TahaGemici/archozu/DTR/DTR.docx

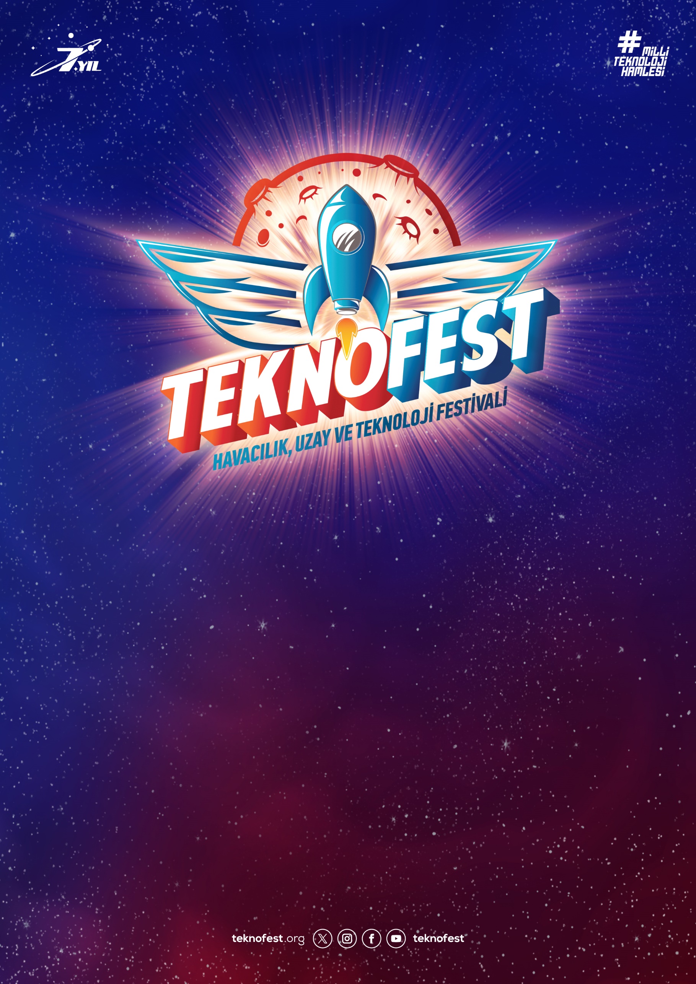
[picture p1: figure]

ÇİP TASARIM YARIŞMASI

2024

MİKRODENETLEYİCİ TASARIM KATEGORİSİ

DETAY TASARIM RAPORU

ArchOzU

……………………………….

2007098

………………………………

# 1. SİSTEM TANIMI VE TEMEL TASARIM ÖZETİ

Bu proje, OpenHW tarafından geliştirilen 4 aşamalı CV32E40P RISCV çekirdeğine çeşitli çevre birimlerini ekleyerek mikrokontrolcü yapmayı hedeflemektedir. Bu çevre birimleri şu şekildedir:

| RTL Tasarımı | UVM/Simülasyon Testi | İmplementasyon Testi
UART | ✓ | ✓ | 🛠
I2C Master | ✓ | ✓ | 🛠
QSPI Master | ✓ | ✓ | 🛠
Timer | ✓ | ✓ | ✓
GPIO | ✓ | ✓ | ✓
JTAG | ❌ | ❌ | ❌
USB | 🛠 | ❌ | ❌

Tablo 1: Çevre birimlerinin tamamlanma oranı

Yeşil renk tamamlandığını, sarı renk devam ettiğini ve kırmızı renk başlanmadığını göstermektedir.

Bu çevre birimlerinin çekirdek ile bağlantısının kurulabilmesi için bus ve çevre birimi belleği modülleri kullanılmıştır. USB ve JTAG, DTR sonrasına bırakılmıştır. Sistemin şu anki halinin fiziksel tasarımı tamamlanmıştır.

# 2. PROJE DETAY TASARIMI

## 2.1. Sistem Mimarisi

Projenin tamamlanan kısmının blok şeması aşağıdaki şekildedir:

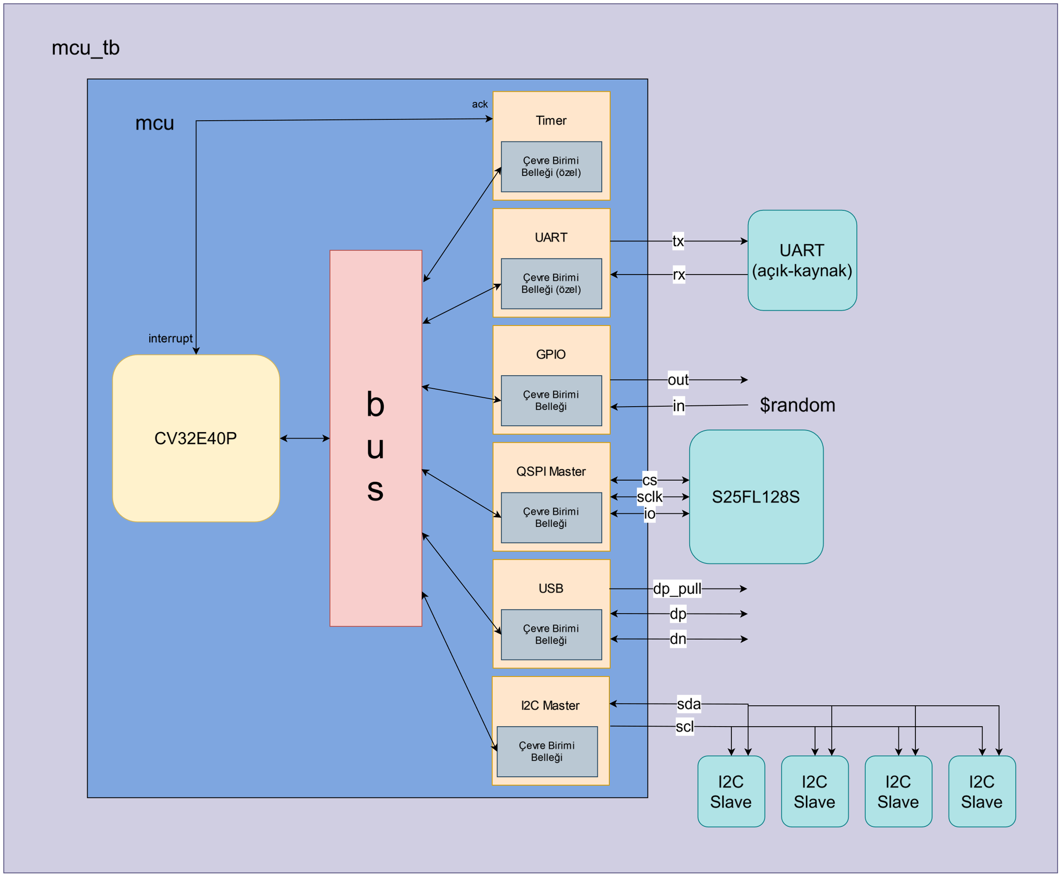
[picture p2: figure]

Şekil 1: Sistemin blok şeması

CV32E40P: Sistemin RISCV çekirdeği buradadır. Tüm işlemler burada yapılır.

Bus: Çevre birimleri ile çekirdek arasında aracılık yapar. Çekirdeğin tüm çevre birimlerine önceliği vardır yani tüm çevre birimleri çekirdek gözünden slave diyebiliriz.

Timer: Çekirdeğin interrupt yapabilmesini sağlar. Bu çekirdek ile gerçek zaman arasında bağlantı kurmak için önemlidir.

UART: UART protokolünü kullanarak veri aktarımını sağlar.

I2C Master: I2C protokolünü kullanarak veri aktarımını sağlar.

QSPI Master: QSPI protokolünü kullanarak Flash bellek ile (şart değil) iletişim kurulabilmesini sağlar.

USB: USB aygıtlarıyla iletişim kurabilmesini sağlar. Henüz bitmedi.

JTAG: Çekirdeğin debug edilebilmesini sağlar. Henüz başlanmadı, o yüzden şematikte yok.

Kendi yazdığımız bus yapısını kullandık. Az sayıda çevre birimi olduğundan bu bus yapısında okuma/yazma gecikmesi 1 cycle’dır. Çekirdek önce 0x2000 adresinden okur. Bu komut belleğindeki bootloader koduna denk gelmektedir. Bootloader kodu QSPI modülüne gerekli emirleri vererek komut ve veri belleklerini doldurur. x2 (ya da sp) yazmacını ayarlar ve 0x0000 adresine (komut belleğindeki ilk adrese) dallanır.

C programlarının derlenmesi için GCC kullanılmıştır. Yazılımcının çevre birimlerini rahat bir şekilde kullanabilmesi için yazmış olduğumuz header’ı eklemesi gerekir. Sisteme uygun bir linker script de hazırlanmıştır.

Aslında FPGA ve ASIC arasındaki temel fark STA ve alandan geçiyor. Özetlemek gerekirse FPGA’de komut ve veri belleği Xilinx’in XPM modülleri kullanılarak oluşturulmuş oluyor yoksa sistem ciddi şekilde (%400->%40) yer kaplıyor. Aynı şekilde clock gate modülü için Xilinx’in BUFGCE modülünü kullanılıyoruz.

Ayrıntılı bilgilere Tasarım Detayı bölümünde ulaşabilirsiniz.

## 2.2. Tasarım Detayı

### 2.2.1. İşlemci ve Bus Yapısının Tasarımı

Mcu modülünde işlemci ve bus birbirlerine bağlanıyor. Bu bağlantıların ne olduğunu detaylandırmak gerekirse:

- Komut belleği arayüzü portları
- Veri belleği arayüzü portları
- Interrupt portları

Önce APB + AHB kombinasyonunu denedik lakin karmaşık geldiği ve slave’lerin her zaman yanıt vereceğini gördüğümüz için bundan vazgeçtik. Aynı zamanda çok fazla çevre birimi olmadığı için bus yapısını kendimiz hazırladık. Hem bus’a hem de işlemciye saat ve reset sinyalleri gitmektedir. FPGA implementasyonunda saat sinyali FPGA’de halihazırda bulunan osilatörden, reset sinyali ise butondan gelmektedir (Elle etkinleştirilir). Bus’tan çıkan çevre birimi telleri mcu modülünden çıkış portu olarak verilmektedir. Bu portların karşılık geldiği pinler xdc dosyasında belirtilmiştir. FPGA’de flip-flopların baştaki değerleri belirlenebilmektedir. Dolayısıyla reset sinyaline pek ihtiyaç yoktur, lakin ASIC’te aynı durum geçerli olmadığından yine de reset sinyali gerektikçe kullanılmaktan çekinilmemiştir. İşlemci ile bus arasında veri belleği, komut belleği ve interrupt bağlantıları bulunmaktadır.

Bus yapısını biz hazırladığımız için rahatça değişiklik yapabildik. APB protokolünü seçseydik çok değişiklik yapamazdık. Şartnamedeki çevre birimleri de APB’yi zorunlu tutacak cinsten değildi. Ayrıca bu tercih, bus’ın nasıl çalıştığını çok daha iyi anlamamızı sağladı. Dahası, APB+AHB kombinasyonuna göre çok daha az yer kaplıyor. Sıfırdan bus yapısı yazmak çok fazla hata yapmamıza sebep oldu. Hataları çevre birimlerini test ederken gördükçe düzelttik.

### 2.2.2. Peripheral Tasarım Detayları

Hangi modülleri bizim yazdığımızı ve hangi modülleri hazır alacağımızı gösteren tablo aşağıdadır:

Bizim yazdığımız modüller | Hazır alacağımız modüller
UART | JTAG
I2C Master | USB
QSPI Master
Timer
GPIO
Çevre Birimi Belleği
Bus

Tablo 2: Modüllerin listesi

### 2.2.2.1. Çevre Birimi Belleği

Bus’ı tasarlarken önce veri belleğini 8kB’tan daha büyük yapıp tüm çevre birimlerine erişim hakkı vermeyi düşündük lakin bu sistemi inanılmaz karmaşık yapıyordu. Daha sonra çevre birimlerinin içerisinde yazmaç olarak tutmayı denedik. Bu sistem çalışıyordu fakat hata yapmaya çok müsaitti, debug etmesi çok zordu ve aynı anda tüm yazmaçları okumuyorduk. Dolayısıyla bir verimsizlik vardı. Ek olarak tüm çevre birimleri için benzer adımları tekrar etmek gerekiyordu. Tüm bunları çözen bir modül yazmaya karar verdik. Bu modüle “Çevre Birimi Belleği” dedik. Çevre Birimi Belleği, çekirdek ile çevre birimi arasında aracılık yapmaktadır. İçerisinde şartnamede belirtilen yazmaçları tutar. Hem çekirdek hem de çevre birimi yazma/okuma işlemleri yapabilir. Modülün blok şeması aşağıdaki gibidir:

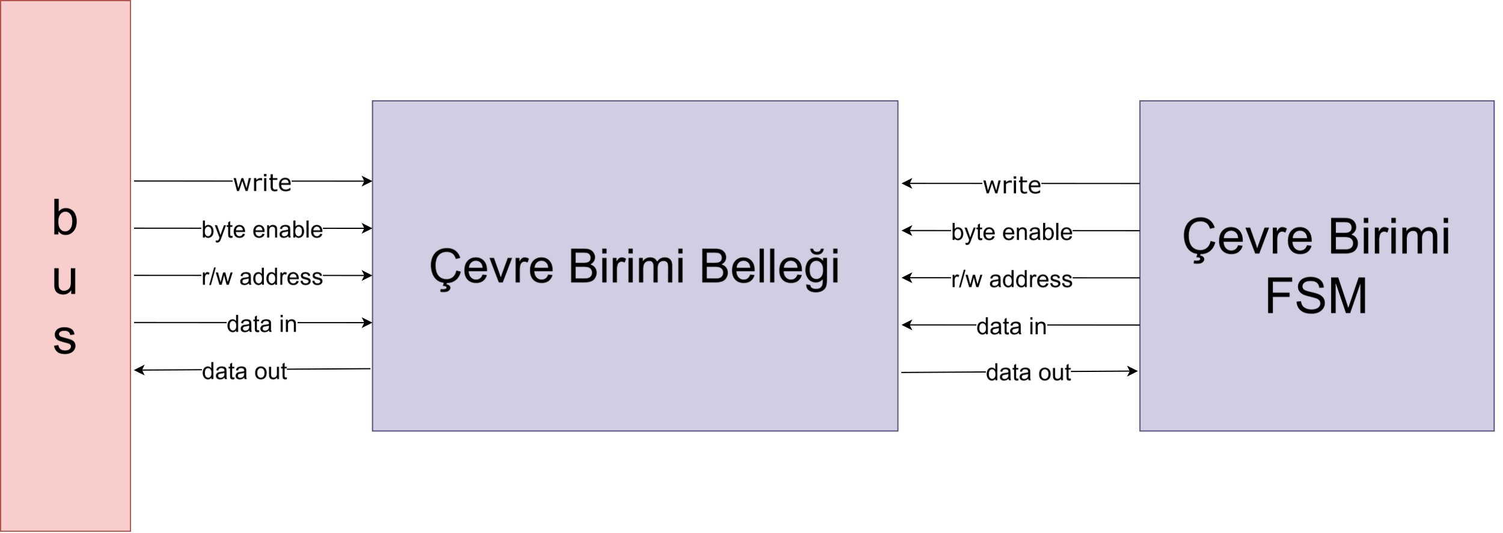
[picture p3: figure]

Şekil 2: Çevre Birimi Belleği

Çevre birimlerinde sık sık rastlanan bir örüntü gördük: Okunmak istenen ile yazmak istenen yazmaçların her zaman aynı olmaması. Bu yüzden çevre birimlerine çekirdeğin bağlantılarına ek olarak okuma adresi koyduk. Çevre birimi belleğinin büyük bir dezavantajı olabileceğini fark ettik: Aynı adrese her iki taraftan da yazma isteği gelirse ne olacak?

Böyle bir durum söz konusu değil çünkü tüm çevre birimlerindeki yazmaçların fonksiyonları o kadar iyi belirlenmiş ki kullanım talimatlarına uyan bir yazılımcı çekirdekten çevre birimiyle çakışacak yazma isteği gönderemez. Şöyle ki, çevre birimlerinde işlemin tamamlandığını söyleyen bir yazmaç var. Eğer işlem tamamlanmışsa/başlamamışsa, söz konusu çevre biriminin hiçbir yazmaca yazma emri vermeyeceğinin garantisini veriyoruz. Öteki taraftan, eğer işlem devam etmekte ise yazılımcı bize bunun garantisini vermelidir. Yazılımcıdan işlemi başlattıktan sonra işlemin devam etmekte olduğunu gösteren yazmacı okumadan diğer yazmaçlara yazma emri vermemesini istiyoruz. Bu anlaşma sayesinde, aradaki uyumsuzluk giderilir. Yazdığımız header’ı kullanan birisinin bunları hesaba katmasına gerek yoktur. Header bu husus göz önünde bulundurularak yazılmıştır.

Bazı yazmaçlar çekirdek tarafından yalnızca okunabilir. Hangi yazmaçların yazılabileceği ve yazmaçların toplamının büyüklüğü çevre birimi belleğine parametre olarak verilir.

### 2.2.2.2. UART

Şekil 3: UART waveform

Tek yönlü tel(ler) kullanır. TX teli karşı tarafa veri iletmek için, RX teli ise karşı taraftan veri almak için kullanılır. UART, oldukça basit bir protokoldür. Özetlemek gerekirse:

- Start biti gönderilir.
- Veri gönderilir.
- Parity bit gönderilir. [Opsiyonel]
- Stop biti gönderilir.

RX ve TX tellerinin çalışma prensibi tamamen aynıdır ve birbirinden bağımsız olarak çalışır. Dolayısıyla iki farklı FSM bulunmaktadır. Verici FSM şu şekilde çalışır:

1. IDLE: TX teline 1 yaz. Geçerli yazma emri gelirse START state’ine geç.
2. START: Start biti oluşturmak için TX teline 0 yaz. Sayacı sıfırla. DATA state’ine geç.
3. DATA: TX teline bus’tan gelen 8-bitlik veriyi sayacı göz önünde bulundurarak LSB en başta olmak üzere sırasıyla yaz. Sayaç bitince STOP state’ine geç.
4. STOP: Stop biti oluşturmak için TX teline 1 yaz. Bus’tan gelen stop bit uzunluğu isteği kadar bekle. Seçenekler arasında 1.5 cycle da bulunduğu için STOP state’ine geldiğinde frekans 2 katına çıkar ve 1-1.5-2 cycle yerine sırasıyla 2-3-4 cycle bekler. TX teli açısından değişen bir durum olmaz.

Alıcı FSM çok benzer şekilde çalışır:

1. IDLE: RX teli 0 olunca START state’ine geç.
2. START: Sayac sıfırla. Yarım cycle bekle ki okuduğun veriler tam ortadan alınsın. Metastabilite riskini minimuma indir.
3. DATA: RX telinden gelen 8-bitlik veriyi sayacı göz önünde bulundurarak LSB en başta olmak üzere sırasıyla geçici bir yazmaca yaz. Sayaç bitince STOP state’ine geç.
4. STOP: Geçici yazmaçtaki değeri, asıl yazmaca (UART_RDR) yaz.

Alıcı FSM’de direk asıl yazmaca yazmak yerine geçici bir yazmaca yazıp. Daha sonrasında bu geçici yazmacı asıl yazmaca yazmamızın bir sebebi var: Varsayalım UART üzerinden bir sensöre sürekli veri okuma emri gönderiyorsunuz ve hedefiniz en güncel veriyi almak olduğu için sürekli UART_RDR yazmacını okuyorsunuz. Eğer alıcı FSM DATA state’indeyken okursanız okuduğunuz veri hem eski bitleri hem de güncel bitleri size verir. Bu da çok farklı sayılara denk gelebilir. Her ne kadar peripherals.h header’ında buna karşın önlem alınmış olsa da kullanılması zorunlu olmadığı için donanım seviyesinde bu önlem alınmıştır.

### 2.2.2.3. I2C Master

Şekil 4: I2C Master waveform

SDA ve SCL adında iki tel kullanılır. SDA çift yönlüdür. SCL, tek yönlüdür. Normalde SCL de çift yönlüdür fakat sistemde tek bir master olduğu için SCL teline yazan sadece bir tane modül vardır. I2C protokolünü özetlemek gerekirse:

- SCL 1 iken SDA 0 olursa başlangıç anlamına gelir.
- SCL 0 iken SDA 1 olursa bitiş anlamına gelir.
- Başlangıç ve bitiş arasında SCL 1 iken SDA değişemez.
- Adresler 7 bittir.
- Veriler 8 bittir.
- Sırasıyla “başlangıç + adres + okuma + ack + veri + ack/nack + bitiş” şeklindedir. 8 bitten daha fazla veri göndermek istenirse “veri + ack/nack” tekrarlanır.

Bu çevre biriminin içerisinde 8 state’den oluşan FSM bulunmaktadır. Stateler sırasıyla şu şekildedir:

1. IDLE: I2C_CFG yazmacında tamamlanmamış yazma ya da okuma emri varsa START state’ine geç. Yalnızca okuma emri geldiği zaman oku (Yazma öncelikli).
2. START: 3 bitlik sayacı sıfırla. SCL teline master clock’tan oluşturulmuş senkron frekansı düşük clock sinyalini ver. Start condition oluşması için SDA teline 0 yaz. ADDR state’ine geç.
3. ADDR: I2C_ADR yazmacındaki adresi SDA teli üzerinden gönder. Sayaç tamamlandığında ACK0 state’ine geç.
4. ACK0: Sayacı sıfırla. SDA teline yazmayı bırak. SDA teli 0’lanmışsa (ACK) bir sonraki state’e geç. Bir sonraki state yazma yapılacaksa WDATA yoksa RDATA’dır.
5. WDATA: I2C_TDR yazmacından bir byte’lık veri gönder. Sayaç tamamlandığında ACK1 state’ine geç.
6. RDATA: SDA telinden I2C_RDR yazmacına bir byte’lık veri yaz. Sayaç tamamlandığında ACK1 state’ine geç.
7. ACK1: Sayacı sıfırla. I2C_NBY yazmacındaki sayı kadar (1-4 aralığına göre düzenlenmiş şekilde) önceki state’i tekrarla. Yazma modundaysak ve SDA telinden ACK sinyali gelmemişse tekrar göndermeyi dene (işlemin komple iptal edilemesine tercih edilmiştir, ileride değişiklik yapılabilir). Tekrarlar tamamlandıysa STOP state’ine geç. Okuma işlemi yapıyorsak son byte hariç ACK gönder. Son byte’ta slave’in daha fazla istemediğimizi anlaması için NACK gönder. Yazma işlemi yapıyorsak SDA teline yazmayı bırak.
8. STOP: STOP condition oluşması için SDA teline 1 yaz. SCL teline de gecikmeli 1 yaz. İşlemin tamamlandığını belirtmek için I2C_CFG yazmacını düzelt. IDLE state’ine dön.

### 2.2.2.4. QSPI Master

Şekil 5: QSPI Master waveform

QSPI’da SCLK telinden saat sinyali, CSn telinden select sinyali ve io tellerinden (4 tane) veri aktarılır. Şartname açısından QSPI protokolünü özetlemek gerekirse io tellerine yazılanlar sırasıyla şu şekildedir:

1. 8 bitlik komut gönderilir.
2. 24 bitlik adres gönderilir. [Opsiyonel]
3. Dummy cycle(’lar) gönderilir. [Opsiyonel]
4. Veri gönderilir/alınır. [Opsiyonel]

QSPI Master modülünün yükünü hafifletmek için oldukça esnek bir şekilde yazdık. QSPI Master modülünün konfigürasyonunu tamamen yazılıma bıraktık. İçerisinde 4 state’den oluşan FSM bulunmaktadır. State’ler sırasıyla şu şekildedir:

1. IDLE: Sayacı sıfırla. QSPI_STA yazmacına işlemin bittiğini belirten biti yaz. io tellerinden sadece 1.sine (boş) veri yazılabilsin.
2. CMD: QSPI_STA yazmacına meşgul olduğunu belirten biti yaz. X0 modunda isek IDLE state’ine geç(bitir).Dummy cycle istendiyse DUMMY state’ine geç, yoksa EXECUTE state’ine geç.
3. DUMMY: QSPI_ADR yazmacındaki adresi oku. Okunan bitleri sırasıyla io bağlantısındaki 1. tele yaz. Eğer istenilen dummy cycle adresin uzunluğundan fazlaysa başa dön ve tekrar oku. İstenilen cycle kadar beklendiğinde EXECUTE state’ine geç.
4. EXECUTE: Sayaç sıfırlanınca IDLE state’ine dön.
  a. Okuma modu:
    i. x1: 4 bitlik io bağlantısının 2. telinden okuduğun veriyi sayacı göz önünde bulundurarak ilgili bölüme yaz. Sayacı 1 azalt.
    ii. x2: 4 bitlik io bağlantısının ilk 2 telinden okuduğun veriyi sayacı göz önünde bulundurarak ilgili bölüme yaz. Sayacı 2 azalt.
    iii. x4: 4 bitlik io bağlantısının tüm tellerinden okuduğun veriyi sayacı göz önünde bulundurarak ilgili bölüme yaz. Sayacı 4 azalt.
  b. Yazma modu:
    i. x1: 4 bitlik io bağlantısının 1. teline QSPI_DRx yazmacından okuduğun veriyi sayacı göz önünde bulundurarak yaz. Sayacı 1 azalt.
    ii. x2: 4 bitlik io bağlantısının ilk 2 teline QSPI_DRx yazmacından okuduğun veriyi sayacı göz önünde bulundurarak yaz. Sayacı 2 azalt.
    iii. x4: 4 bitlik io bağlantısının tüm tellerine QSPI_DRx yazmacından okuduğun veriyi sayacı göz önünde bulundurarak yaz. Sayacı 4 azalt.

QSPI Master’da adresin yazımıyla dummy cycle’ın yazımını aynı state’de yapıyoruz. Bunun sebebi, dummy cycle’da io bağlantısının 1. teline yazılan verinin önemsiz olmasıdır. Böylece hem adresi göndermeyi hem de dummy cycle yazmayı aynı devre ile yaparak alandan tasarruf ediyoruz. Yazdığımız bu modülün içerisine komutları gömmediğimiz için yalnızca şartnamede belirtilen S25FL128S flash belleği ile değil, birçok bellekle uyumlu bir şekilde çalışabiliyor. Bu anlatılanlar göz önünde bulundurulduğunda QSPI_CCR yazmacına atamalar şu şekilde yapılıyor:

1. QSPI_CCR[9:8] bölümüne veri modu yazılıyor. Veri modu EXECUTE state’inde kaç tane tel kullanılacağına göre belirtiliyor. Eğer sadece komut gönderilecekse 0 yazılması gerekiyor.
2. QSPI_CCR[15:11] bölümünü önce şartnamedeki gibi içeride yazan sayı kadar cycle diye baz aldık ama sonra fark ettik ki bu mümkün değil. Çünkü 5 bitlik yazılabilecek en yüksek sayı 31 ve S25FL128S flash belleğinde 24b adres + 8 dummy cycle = 32 cycle DUMMY(bizim FSM cinsinden) gerekiyor. Adres 24b ya da 32b. İki sayı da 8’e bölünüyor. Kullanıcının 8’in katı olan bir sayı kadar dummy cycle isteyeceğini baz alıp yazılan sayının 8 katı kadar DUMMY state’inde kalıyoruz. Dolayısıyla CMD ve EXECUTE state’leri arasında minimum 0, maksimum 256 cycle bekleyebilirsiniz.
3. QSPI_CCR yazmacının geri kalan kısmına ek bir yorumumuz yok.

Bu açıklamalar göz önünde bulundurulduğunda şöyle bir tablo çıkıyor karşımıza:

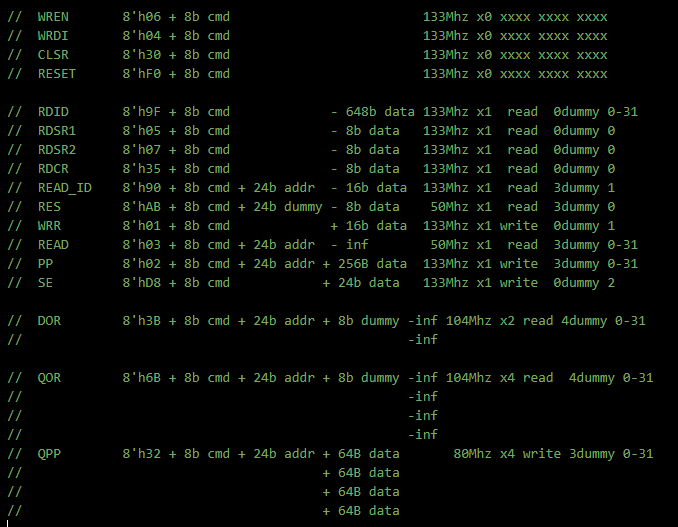
[picture p4: figure]

Denklem 1: QSPI Master S25FL128S analizi

### 2.2.2.5. Timer

Çekirdek interrupt işlerini Machine CSR’lar ile halleder. Machine CSR’ların başka görevleri olanları da var ama biz doğrudan sadece 3 tanesiyle ilgileniyoruz. Dolaylı olarak ilgilendiğimiz birçok CSR yazmacı da var ama burada bundan bahsetmedik. Değişiklik yaptığımız CSR yazmaçları ve görevleri şu şekildedir:

Machine CSR’lar | Görevleri
mtvec | Interrupt olduğunda burada tutulan adrese dallanılır.
mstatus | Mie CSR’ını aktif etmek de dahil birkaç ayarı mevcuttur.
mie | Machine interruptları (timer bunlardan biri) burada aktif edilir.

Tablo 3: Machine CSR'lar ve görevleri

Yazılımcının Timer modülünü kullanması için peripherals.h headerında yazmış olduğumuz timer_conf(…) fonksiyonunu kullanmış olması gerekir. Bu fonksiyonun görevlerinden biri CSR yazmaçlarını ayarlamasıdır. mtvec yazmacına 0x2200 (ayrıntılı bilgi linker bölümünde) yazılır. mstatus yazmacının 3. pini aktif edilir. Bu pin machine interruptlarının değerlendirilmesini sağlar. Machine interruptlarından da ihtiyacımız olanı aktif etmemiz gerekiyor. Bu ayarı da mie yazmacından yapıyoruz. mie yazmacından 7. pini aktif ediyoruz. Bu pin Timer interruptlarına denk geliyor. Böylece çekirdek Timer interruptlarını almaya hazır oluyor. Interrupt fonksiyonuna girince mie yazmacının 7. biti mret gelinceye kadar (fonksiyondan çıkıncaya kadar) 0 oluyor. Bu interrupt içinde interrupt olmasını engellemek içindir. OpenHW, nested interruptın yapılıp yapılamayacağını kullanıcıya bırakmıştır. Şartnamede bu durumdan bahsedilmediği için biz varsayılan ayar olan interrupt içinde interrupt isteğinin umursanmaması durumunu değiştirmedik.

Timer modülü, çekirdeğe interrupt sinyali verir. Çekirdek, Timer’a interrupt sinyalinin kabul edilip edilmediğini ve kabul edildiyse kabul edilen interruptın id’sini verir. Timer, kabul edilen interrupt’ın id’si 7 mi diye kontrol ediyor sürekli. Henüz 7 dışında bir interrupt geldiğini görmedik ve olacağını düşünmüyoruz ama yine de bu kontrol mekanizmasını bıraktık. Çekirdek interrupt sinyalinin kabul edildiğini söyleyene kadar Timer interrupt sinyali vermektedir. Timer’ın prescaler değerinin düşük olması interrupt fonksiyonu bitmediği için interrupt sinyallerinin gözden kaçırılmasına yol açabilir. Bunu göz önünde bulundurmak yazılımcının sorumluluğundadır. Gerekirse Timer interrupt’ın içine girildiğinde devre dışı bırakılmalıdır.

TIM_CLR yazmacına 1 yazılırsa TIM_CNT yazmacı ve sayaç sıfırlanır. TIM_EVC yazmacına 1 yazılırsa TIM_EVN sıfırlanır. TIM_CLR ve TIM_EVC yazmaçları 1 cycle sonra 0’a çekilir.

Timer’ın içerisinde 32 bitlik bir sayaç bulunur. Bu sayaç TIM_PRE sayacına yazılan değere ulaşana kadar artar. TIM_PRE yazmacına -1 yazılmışsa (saat frekansı – 1) değerine ulaşıncaya kadar artar.

TIM_ENA yazmacı 1 ise ve sayaç TIM_PRE’ye eşitse:

- Sayaç sıfırlanır.
- TIM_MOD 1 ise TIM_CNT 1 arttırılır. Değilse, 1 azaltılır.
- TIM_ARE, TIM_CNT’ye eşitse:
  - TIM_CNT sıfırlanır.
  - TIM_EVN 1 arttılır.
  - Interrupt sinyali verilir.

### 2.2.2.6. GPIO

Oldukça basit bir çevre birimidir. İçerisindeki çevre birimi belleğinde 2 tane yazmaç bulunur. in tellerinden gelen veriyi GPIO_IDR yazmacına yazar. GPIO_ODR yazmacına yazılan veriyi out tellerine verir. Bahsi geçen tellerin yönü sabittir.

### 2.2.3. Yazılım Ortamı

Hazırlamış olduğumuz sistemi daha rahat programlayabilmek adına bir yazılım ortamı oluşturduk. Bu yazılım ortamı şu dosyalardan oluşmaktadır:

- peripherals.h
- main.c
- linker_script.ld
- mem_file_gen.sh
- hex2mem.py

### 2.2.3.1. peripherals.h

C dilinde yazılmış header dosyasıdır. Bu header dosyası çevre birimlerinin kolayca ve güvenli bir şekilde kullanılması içindir. İçerdiği fonksiyonlar ve kullanım şekilleri:

- UART:
  - Konfigüre et (baud rate, stop bit)
  - Yaz (veri)
  - Oku
- I2C:
  - Konfigüre et (adres)
  - Yaz (veri, byte sayısı)
  - Oku (byte sayısı)
- QSPI:
  - S25FL128S WREN
  - S25FL128S WRDI
  - S25FL128S CLSR
  - S25FL128S RESET
  - S25FL128S RDID (…)
  - S25FL128S RDSR1
  - S25FL128S RDSR2
  - S25FL128S RDCR
  - S25FL128S READ_ID (…)
  - S25FL128S RES
  - S25FL128S WRR (…)
  - S25FL128S READ (…)
  - S25FL128S PP (…)
  - S25FL128S SE (…)
  - S25FL128S DOR (…)
  - S25FL128S QOR (…)
  - S25FL128S QPP (…)
  - Yaz [S25FL128S olmak zorunda değil]
  - Oku [S25FL128S olmak zorunda değil]
- Timer:
  - Konfigüre et (prescaler değeri, auto reload değeri, mod)
  - Sayacı oku
  - Event’i oku
  - Sayacı sıfırla
  - Event’i sıfırla
  - Çalıştır
  - Durdur
- GPIO:
  - Yaz (veri)
  - Oku
- Veri Belleği
  - Yaz (adres, veri)

USB’nin fonksiyonları henüz tasarlanmadı.

### 2.2.3.2. main.c

Yazılımcının bu dosyada main fonksiyonunu tutması beklenir. Main fonksiyonundan çıkış olmamalıdır. Aksi takdirde olacak durumdan yazılımcı sorumludur. Main fonksiyonundan çıkış olmayacaksa bile bazen GCC bunu anlayamaz. Gereksiz yükleme ve depolama komutları yazılmaması için naked attribute’u verilebilir.

Interrupt yapılmak isteniyorsa interrupt fonksiyonunun adı interrupt olmak zorundadır. Yazılımcının yükünü hafifletmek için interrupt fonksiyonuna interrupt(“machine”) attribute’u verilmesini tavsiye ediyoruz. Çünkü interrupt fonksiyonlarında sözde ret komutu ra yazmacındaki adrese gitmenizi sağlar. Halbuki interrupt fonksiyonlarında bu anlamsızdır çünkü dönülecek adres ra yazmacında tutulmaz, MEPC yazmacında tutulur. Kullanılması gereken komut mret idir. Ayrıca değiştirilen her yazmaç (klasik fonksiyonların aksine istisnasız bir şekilde) interrupt gerçekleştiği andaki haline döndürülmelidir. Bu attribute, bütün bunları sizin için yapar.

Çevre birimlerini kullanmak istiyorsanız peripherals.h’yi programınıza eklemenizi tavsiye ederiz. Çevre birimlerinin nasıl çalıştığını anlamadan yalnızca istenilen değerleri girerek çevre birimlerini kullanabilirsiniz.

### 2.2.3.3. linker_script.ld

Linker script dosyasıdır. Oldukça küçük bir dosyadır. Linker’a nasıl davranması gerektiğini söyler. Bildiğimiz kadarıyla, GCC’nin linker’ı yalnızca Von Neumann mimarisini destekliyor. Dolayısıyla burada ekstra bir işlem yapmamız gerekiyor. MCU ve Linker gözünden iki farklı bakış açımız var:

| Harvard (MCU) | | Von Neumann (Linker)
| Bus | Komut Belleği
0x0000 | Veri Belleği | bootloader | Veri Belleği
0x2000 | kullanılmıyor | main() | main()
0x2200 | | interrupt() + diğer() | interrupt() + diğer()
0x4000 | Komut Belleği | --------------> | Komut Belleği
0x6000 | UART | --------------> | UART
0x8000 | I2C | --------------> | I2C
0xA000 | QSPI | --------------> | QSPI
0xC000 | Timer | --------------> | Timer
0xE000 | USB | --------------> | USB
0x10000 | GPIO | --------------> | GPIO

Tablo 4: Linker script analizi

Linker’a çevre birimlerinin adresi olduğu gibi verildi. İşlem yetkisi yok, sadece okuma ve yazma var. Dolayısıyla bu birimlere erişim sadece veri belleği adresleri üzerinden yapılıyor (Memory-mapped). Bootloaderı GCC’de normal yazdık. Daha sonra adresleri elle 0x0000’a hizalı bir şekle çevirdik ve bu şekilde kaydettik. Veri belleğinin başlangıç adresinin 0x0000 olduğunu görüyorsunuz. Bitişi 0x2000’e denk geliyor. GCC verileri sp yazmacını eksilterek yazıyor. Bootloaderın komut belleğine dallanmadan önce sp yazmacına 0x2000 yazmasının sebebi işte bu. Interrupt fonksiyonunun adresini sabit 0x2200 olarak belirledik. Eğer main fonksiyonu 0x2000 ile 0x2200 arasına sığmazsa GCC hata veriyor. Bu yüzden main fonksiyonunun gerekirse parçalanmasını tavsiye ederiz. Diğer fonksiyonlar interrupt fonksiyonunun hemen ardından başlıyor (0x4000’e kadar). 0x4000’deki komut belleği sizi şaşırtmasın. Burası yalnızca komut belleğine yazmak için ayrılan adres. 0x4004 ve sonrası umursanmıyor.

Lakin veri belleğinde bir sorunumuz var. GCC, yazdığınız programın veri kısmını 0x0000’dan başlayarak hex dosyasına yazıyor (.dynamic, .sdata vb. şekillerde). Bootloader, bu verileri veri belleğine yazıyor. Lakin veri belleğine aynı zamanda 0x2000’den aşağı yönde giden veriler de yazılıyor program çalışırken. Linker, sp yazmacının ilk baştaki değerini bilmiyor. Dolayısıyla bu iki veri kümesi çakışırsa yazılımcıya veri belleği taşması hatası verilmiyor. Açıkçası biz veri belleğini sonuna kadar kullanamadık ama yazılımcının yine de bunu göz önünde bulundurması gerekir.

### 2.2.3.4. mem_file_gen.sh

main.c yazıldıktan sonra çalıştırılması gerekilen dosya budur. GCC’yi uygun parametrelerle çalıştırır. hex2mem.py dosyasını çalıştırır.

### 2.2.3.5. hex2mem.py

mem_file_gen.sh dosyasının ürettiği hex uzantılı dosyadan mem dosyaları üretir. Bu dosyalar şunlardır:

- s25fl128s.mem
- instr_mem_no_flash.mem
- data_mem_no_flash.mem

s25fl128s.mem flash belleğe yüklenmesi gerekilen dosyadır. İçerisinde .text bölümleri ve .data bölümleri bulunur. .data olanlar 0x0000 ile 0x2000 arasına yazılır. .text olanlar 0x2000 ile 0x4000 arasına yazılır. *no_flash.mem olanlar ise implementasyon için flash bellek devre dışı bırakıldığında ilgili belleğin ilk baştaki değerlerini tutar.

### 2.2.4. FPGA Prototipleme Detayları

Elimizde S25FL128S model Flash bellek olmadığı için FPGA’e gömebiliriz diye düşündük. Fakat Vivado, boyutu çok büyük olduğu için sentezde hata verdi. Bu yüzden “defines.vh” headerına “`define NO_FLASH” diye bir satır ekledik.

Bu satır FPGA implementasyonunda Flash belleğe önceden yazılmış olacağını varsaydığımız programı komut belleğine yazıyor. Aslında bir nevi QSPI protokolünü baypas ediyoruz. Bootloader kodu da sadece komut belleğine dallanmak için programlanıyor.

FPGA olarak Digilent Basys3 (A7-35T) kartını seçtik. Bağlantıları şu şekilde yaptık:

- Osilatör (pin W5): Saat
- Anahtarlar: GPIO input
- LEDler: GPIO output
- Buton (pin U18): Reset
- JA: I2C portları
- JB: QSPI portları
- JC: UART portları

USB tamamlanmadığı için port ayırmadık. FPGA kaynaklarının kullanım miktarları şu şekilde:

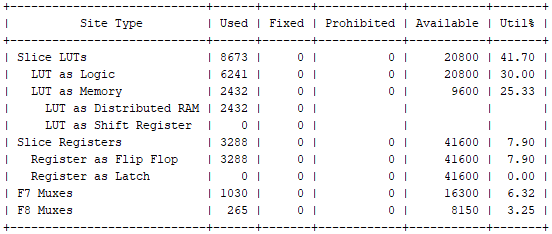
[picture p5: figure]

Tablo 5: FPGA kaynaklarının kullanım miktarları

Timer’ı konfigüre eden ve sonrasında periyodik olarak GPIO’nun giriş portlarından veri okuyup bunu işleyerek (toplama, çıkarma, kaydırma komutları vb. şekilde yorumlayarak) GPIO’nun çıkış portlarına yazan bir program yazdık. Programı derledik ve sentez sırasında çıkan kritik uyarıları çözdük. Sonrasında implementasyon ve bitstream üretim aşamalarını başarılı bir şekilde tamamladık. Bu test sayesinde çekirdek, bus, bootloader kodunu (dallanma yapıp yapmamasını), timer modülünü, işlemcinin interrupt isteklerine yanıt verip vermediğini, GPIO modülünü, linker scripti, program header’ı ve yazdığımız C kodunu doğrulamış olduk.

I2C modülünü Arduino UNO’yu slave olarak bağladıktan sonra test ederken ACK sinyali ile ilgili bir sorun yaşadık. Sorunun FPGA – Arduino uyumsuzluğu olduğunu anladık. DTR’den sonraya bıraktık.

UART ve USB’nin implementasyon testlerini DTR’den sonraya bıraktık.

WNS, -15ns civarında çıkıyor. Bu da maksimum saat frekansı yaklaşık 67MHz demek. En kötü 10 WNS’ye baktık ve birçoğu çekirdeğin içerisindeydi. O yüzden sistemi optimize etme yoluna gitmedik. İmplementasyon testlerini 60MHz saat frekansı ile yaptık. USB için de 60MHz olması gerekiyordu. Ek bir devreye ihtiyaç duymadık.

C kodları için github hesabınızdaki ilgili dosya pathi link verilebilir ama FPGA üzerinde veya simülasyon ortamındaki çalışmalar DTR’de detaylandırılmalıdır. Alınan sonuçlar görsellerle belirtilmelidir. Karşılaşılan zorluklar ve çözümleri?}

# 3. ÇİP TASARIM AKIŞI

{Bütün bir sistemin olmasa da peripheralların biri veya birkaçı ya da işlemci çekirdeği için çip fiziksel tasarım akışının tamamlanması beklenmektedir. Mümkünse tasarımın hepsi, tasarımın hepsi tamamlanmadıysa da tamamlanmış alt modüller üzerinde synthesis, placement ve routing gibi aşamalar sonrasında oluşan zamanlama analizi (timing analysis), kaynak kullanım (utilization) gibi dosyaların çıktılarından yararlanıp yorumlarda bulunulmalıdır. GDSII layout resimleri eklenmelidir. Güç tüketimi, performans ve alan tüketimini iyileştirmek adına akışta yapılan özelleştirmelere değinilmelidir. Tasarım sürecinde gerek yazılımsal olarak gerek tasarımsal olarak karşılaşılan sorunlara ve bu sorunların nasıl çözüldüğüne değinilmelidir (Örneğin P & R programı tasarımı route edemediği şeklinde bir hata vermiştir, yarışmacılar da bu durumu bir yöntemle çözmüştür veya akış sırasında bir hata alınmıştır, bunu çözmek için başka bir commit’teki versiyona geçilmiştir şeklinde). Bu çözümler esnasında kullanılan teorik-genelgeçer bilgilere yer verilmelidir (Örneğin bu kaynaktan edinilen bilgiye göre utilization değeri bu değerin altında tutulmuştur). Açık kaynak programlar kullanıldıysa bahsedilen genelgeçer bilgilerle elde edilen sonuçlar uyumsuzluklar görüldüyse bunların sebebi açıklanmalıdır. Çip tasarım akışı boyunca faydalanılan topluluklar, Slack kanalları gibi yerler varsa bunların hangilerinden ne yönde yararlanıldığından bahsedilmelidir. Çip akışında geçirilen aşamaların hangilerinin daha kolay hangilerinin daha zor bulunduğuna, hangilerinde ne kadar zaman geçirildiğine kısaca değinilmelidir.}

Projeden bir tasarım çıktı dosyası alabilmek için OpenLane adlı açık kaynak program kullandık. Bu program kullanırken karşılattığımız bir sürü problemler hatalar oldu. Özellikle açık kaynak bir program olmasından kaynaklı olmasının etkileri vardı bu durumda. Öncelikli olarak Yosys programının system verilog dosyalarını desteklemiyor olmasından kaynaklı olarak bize verilen çekirdek dosyaları sentez aşamasını geçemiyordu. Bu durumla ilgili olarak birkaç farklı çözüm önerisi ile geldik.

Öncelikli olarak tasarım çıktı dosyasının içine çekirdek programlarını dahil etmeden bir tasarım çıktı dosyası oluşturmak denenen çözümlerden biriydi. Bu durum yazdığımız çevre birimlerinin ne kadar alan kapladığını ve çalışıp çalışmadığını görmemizi sağlayan bir test olmasını sağladı. Rapor içerisinde gösterilen resimler, çekirdek kullanılmadan oluşturulan tasarım çıktı dosyaları kullanılarak alınmıştır.

Diğer problemi çözmek için kullanılan yöntemlerden biri system verilog dosyalarını yosys ile sentezleyip tasarım çıktı dosyalarını elde etmekti. Ancak yosys’in kendi içinde desteklediği system verilog özelliklerinden daha fazlasını kullanılarak oluşturulmuş olan system verilog dosyaları yüzüden yosys bu dosyaları sentezleyemedi. Onun yerine yosys’in üzerine çalışılarak oluşturulmuş olan başka bir program olan synlig [1] programını kullanmayı denedik. Bu repository yosys’e system verilog desteği eklemek için yapılmış bir programdı. Bu programı docker konteynırının içerisine kurup çalıştırmayı denedik. Bu kısımla alakalı olarak openlane’in iş zincirinin içerisine entegre etmekle alakalı bir problem yaşadık. Belki bu problem üzerine daha fazla vakit harcansa çözülebilirdi.

Son olarak bir diğer çözüm ise system verilog dosyalarını verilog dosylarınıc çevirmekti. Bunu el ile çevirmenin pek mümkün olmadığı için bazı araçlar kullanmayı denedik. Bunu çevirmeyi sağlayan bir program olan sv2v [2] var. Bu bir github repository’si ve system verilog dosyalarını verilog’a çevirmeyi sağlıyor. Ancak bu program bazı system verilog parametlerini desteklemediği için işimize yarayan yeterli bir çözüm değildi.

[1] https://github.com/chipsalliance/synlig

[2] https://github.com/zachjs/sv2v

# 4. TEST

Yaptığımız testler simülasyon testi ve implementasyon testi olarak ikiye ayrılmaktadır. Simülasyon testinden başarıyla geçen modüller genelde implementasyon testinden de başarıyla geçmektedir fakat gerek FPGA’in yapısal farklılıkları gerek bazı tellerin harici komponentlere ihtiyacı olmaları vb. durumlar başarısızlıkla sonuçlanmasına yol açmaktadır.

Simülasyon ve implementasyon testleri, daha önce de belirtildiği şekilde 60MHz saat frekansında yapılmıştır.

# 4.1. Simülasyon Testleri

Simülasyon testleri, Sistem Mimarisi bölümündeki blok şemasında gösterildiği üzere çevre birimlerinin bağlanacağı cihazların da simülasyona dahil edilmesiyle yapılmıştır. Simülasyon testleri, Vivado 2023.2’nin simülasyon aracı ile yapılmıştır. Simülasyon testinin başarılı olup olmadığı waveform incelenerek anlaşılmıştır. Hataların da bu şekilde farkına varılmıştır.

İşlemcinin doğrulanması için ek bir test yapılmamıştır. Çevre birimleri test edilirken işlemci hep olması gerektiği gibi davranmıştır. İşlemcide bir hata çıksaydı da düzeltmemiz pek mümkün olmazdı.

# 4.1.1. UART [UVM]

UART protokolünün doğrulanması için UVM metodu izlenmiştir. Aşağıdaki figürde benzeri bir UVM ortamının yukarıdan görünümü bulunabilir. Oluşturulan test ortamı scoreboard olmaması haricinde bu hiyerarşik yapıyı izlemektedir ve bu ortam uart_top modülünün doğrulanması için oluşturulmuştur. Figürden sonra oluşturulan UVM ortamının sınıf ve bileşen bazında detaylı açıklamasını bulabilirsiniz.

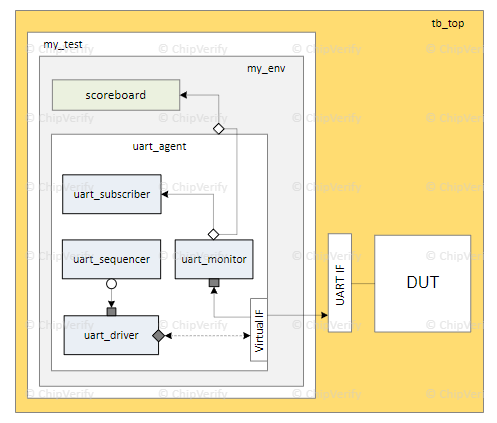
[picture p6: figure]

Şekil 6: Kuşbaşı UART UVM [3]

uart_top (DUT):

Doğrulama altındaki gerçek UART mantığını içerir.

uart_interface:

uart_core modülü için saat, reset ve veri hatlarını içeren iletişim sinyallerini tanımlar. DUT ile iletişim bu arayüzden kurulmaktadır.

uart_trans:

İlgili veri ve meta verilerle birlikte bireysel UART işlemlerini kapsar. Sinyaller üzerinde bazı kısıtlamalar ve modifikasyonlar haricinde arayüzdeki sinyaller oluşturulmuştur.

uart_sequence:

DUT'u uyarmak için sıra öğeleri işlemlerinin akışını yönetir. Sistemin fonksiyonelliğini test etmek için gönderilen verilerden bazıları burada randomize edilmek için ayarlanmaktadır.

uart_sequencer:

Sıra öğelerinin sürücüye gönderilme sırasını ve zamanlamasını kontrol etmektedir. Sequencer, sequence sınıfının içinde tanımlanmıştır.

uart_driver:

Sıra öğeleri işlemlerini DUT arayüzünde pin seviyesi aktivitelerine dönüştürmektedir. Aynı zamanda da scoreboard sınıfı ayrı implemente edilmek yerine burada implemente edilmiştir. Her test için cpb sayısı parametrelerle ayarlanabilmektedir. Regresyon testleri rx ve tx için her testte ayrı ayrı yapılmaktadır. İleri bölümlerde buna daha detaylı değinilecektir.

uart_monitor:

Pin seviyesi aktiviteleri gözlemler ve analiz için bunları tekrar sıra öğelerine dönüştürür. Oluşturduğu sıra öğelerini ‘’functional coverage’’ raporu oluşturmak için subscriber sınıfına gönderir.

uart_cov (subscriber):

Monitor tarafından gözlemlenen sekansları alır ve bu sekansların tasarımın ne kadarını kullandığı bilgisi depolar. En son bütün testler bittiğinde de bu bilgileri ‘’functional coverage’’ olarak raporlar.

uart_agent:

Driver, subscriber, sequencer ve monitorü kapsar. Driver ve sequencer bağlantısı ile monitor ve subscriber bağlantısı burada yapılmaktadır.

uart_env:

Ajanlar ve diğer bileşenleri içeren testbench altyapısını kuran üst düzey ortamdır.

uart_test:

Ortamı yapılandırmak, test senaryolarını ve başlangıç koşullarını tanımlamak için kullanılmaktadır.

tb_uart_top:

DUT'u, arayüzü ve çevreyi örnekleyen, her şeyi birbirine bağlayan ve simülasyonu başlatan üst düzey testbench modülüdü olarak kullanılmaktadır. DUT’a reset sinyalleri buradan verildikten sonra uart testi buradan koşturulmaktadır. Aşağıdaki figürde UVM ortamının nasıl çalıştığı görülebilir.

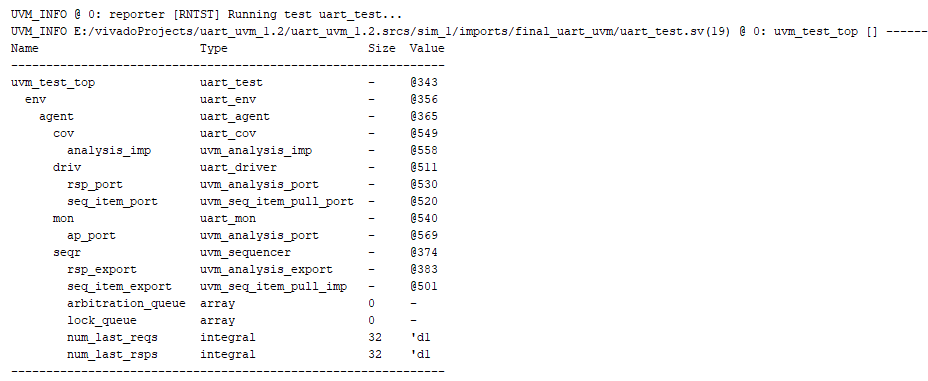
[picture p7: figure]

Denklem 2: Koşturulan UVM ortamı

REGRESYON TESTLERİ

Arayüzle daha kolay iletişim kurabilmek için driver sınıfının içinde yapılmaktadır. Her test hem UART’ın hem rx hem de tx fonksiyonelliğini test etmektedir. Kaç tane test sinyali gönderileceği tb_uart_top modülünden ayarlanabilmektedir. Veri göndermeyi test etmek için, cfg[0]’I 1 yapma gibi gerekli başlama sinyalleri ve gönderilecek randomize edilmiş veri DUT’a gönderilir. Sonra veri gönderiminin tamamlandığını söyleyen sinyal beklenir ve bu sinyalin değerine göre testin geçilip geçilmediği raporlanır. Veri alımını test etmek için ise DUT’a rx portundan 0 gönderilerek veri alımı başlatılır sonra rx randomize edilerek DUT’a sinyal gönderilir. Start, data, ve stop bitleri olmak üzere her verinin gelmesi cpb saat sayısı kadar beklenir ve gönderilen rx verilerinin en son toplanan rx_data_o sinyali ile karşılaştırılması yapılarak testin geçip geçilmediğine bakılır. Özellikle veri gönderimi testleri olmak üzere, regresyon testlerinin daha modüler ve parametrize bir şekilde yapılması amaçlanmaktadır. Örneğin, cpb sinyalini de randomize etmek veya veri gönderiminde gönderilen her veriyi ayrı ayrı test etmek gibi. Aşağıdaki figürde testlerin bir kısmı gözlenebilir.

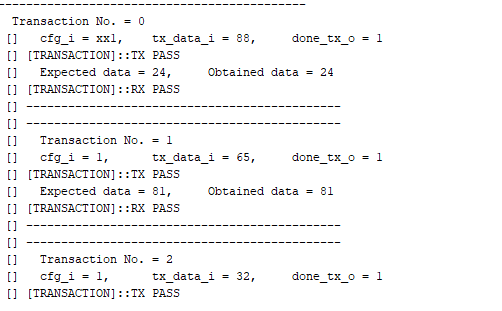
[picture p8: figure]

Şekil 7: Regresyon testleri

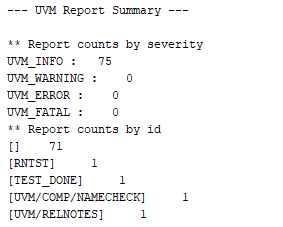
[picture p9: figure]

Şekil 8: UVM rapor özeti

FUNCTIONAL COVERAGE RAPORU

Functional coverage’in raporlanması için DUT’a giren ve çıkan port sinyalleri için ayrı ayrı binler oluşturulmuştur. Veri alımını ve veri gönderimini ayrı ayrı test etmek için ise bunların fonksiyonelliğini kapsıyan cross binler oluşturmuştur. Örneğin, tx_i, tx_data_o ve tx_done sinyallerinin birleştirilmesi gibi. Bu yöntemi izleyen coverage sonuçları aşağıda gözlemlenebilir. Henüz %100 coverage’a ulaşılmamıştır fakat daha kapsamlı testler ile bu sonuca ulaşılması hedeflenmektedir.

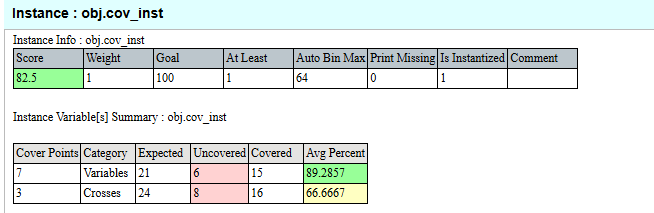
[picture p10: figure]

Tablo 6: Genel Coverage

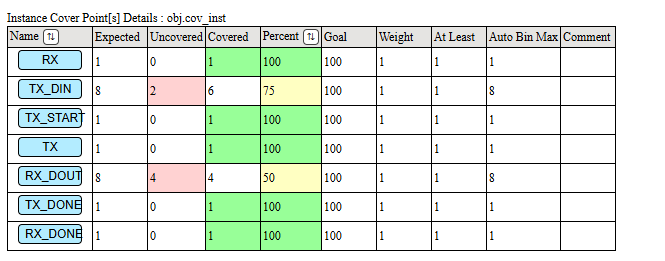
[picture p11: figure]

Tablo 7: Instance Coverage

Tablo 8: Cross Coverage

# 4.1.2. GPIO

in’e sürekli rastgele sayılar yazılıyor. out’a in’den okuduğu sayıyı bir arttırıp yazan bir program yazdık.

# 4.1.3. Timer

Timer’ı her 1 saniyede interrupt yapacak şekilde konfigüre ettik. Interrupt fonksiyonuna daha önceden tanımlamış olduğumuz değişkeni bir arttıran bir bölüm yazdık. Bu değişkeni sürekli GPIO out’a yazdık. Özetlemek gerekirse, saniyede 1 kere artan sayaç yaptık diyebiliriz. Timer’ı diğer konfigürasyonlarla da denedik çalışıyordu. Simülasyonu 1 saniye boyunca çalıştırmak epey zaman aldı.

# 4.1.4. I2C Master

İnternetten açık-kaynak I2C Slave kodu bulunmuştur. 4 tane I2C Slave bağlanılmıştır. Yalnızca adresleri elle ayarlanmıştır. Geri kalan koda bilerek dokunulmamıştır ki olabildiğince uyumluluğu sağlamak için değişen kısım sadece bizim yazdığımız I2C Master olsun.

Birçok küçük boyutta testler denedik ama en kapsamlısı şu testti:

Önce I2C Master’ı, adresini slave’lerden birinin adresiyle aynı olacak şekilde konfigüre ettik. Bir int tanımladık ve bu int’e rastgele bir sayı yazdık. Daha sonra program şöyle bir döngüye giriyor:

- I2C Master’a bu tanımladığımız int’i yazmasını söyleyen fonksiyonu çağır.
- I2C Master’a okumasını söyleyen fonksiyonu çağır. Okuduğu değeri 1 arttır ve bu int’e yaz.

Ayrıca repeated start’ı da denedik. Donanımsal olarak implement etmedik ama yazılımsal olarak art arda iki kere yazma fonksiyonunu çağırarak yapılabildiğini gördük.

# 4.1.5. QSPI Master

QSPI Master’a, internetten açık-kaynak olarak bulduğumuz S25FL128S modülünü bağladık. QSPI Master için özel bir test yapmadık açıkçası, bootloader kodu düzgün çalışıyor mu diye baktık. Waveform’u inceledik. Her şey olması gerektiği gibi olana kadar hataları giderdik. S25FL128S komutlarının yaklaşık 3’te 1’ini test ettik diyebiliriz. Bunun içinde her türden yazma/okuma modu var.

# 4.2. İmplementasyon Testleri

GPIO, Timer ve I2C Master’ın implementasyon testlerini yaptık. UART, USB, JTAG ve QSPI’ın implementasyon testlerini DTR’den sonraya bıraktık.

# 4.2.1. GPIO

Anahtarlardan alınan veriyi okuyan ve okuduğu bu veriyle LED’leri yazan bir program yazdık. İlk denemede başarılı oldu.

# 4.2.2. Timer

Timer’ı her 1 saniyede interrupt yapacak şekilde konfigüre ettik. Interrupt fonksiyonuna daha önceden tanımlamış olduğumuz değişkeni anahtarlardan okuduğu veri kadar artırmasını sağladık. Bu değişkeni sürekli LED’lere yazdık. Özetlemek gerekirse, LED’lerin gösterdiği sayı her saniyede bir anahtarların gösterdiği sayı kadar artıyor. Timer modülünde bazı hatalarla karşılaştık. Bu hataları giderdikten sonra başarılı bir şekilde bu testi tamamladık.

# 4.2.3. I2C Master

I2C Slave olarak Arduino UNO’yu kullandık. 12. ve 13. pini output olarak tanımladık. Wire kütüphanesini kullandık. Bir adres belirledik. Bir değişkende tanımladık. Yazma emri geldiğinde okuduğu değeri bu değişkene yazıyor. Okuma emri geldiğinde bu değişkenin değerini yazıyor.

Bu test yarım kaldı. İlk başta Arduino’yu doğrudan FPGA’e bağlamanın yeterli olacağını düşünmüştük ama sandığımız gibi olmadı. FPGA, Arduino’dan ack sinyalini bazen almıyor. Arduino da gönderilen veriyi yanlış kaydediyor. Bunun gibi anlam veremediğimiz birçok sorun çıktı. İlk başta sorunun yazılımsal olabileceğini ya da RTL kodunda bir sorun olabileceğini düşündük ama sorun donanımsalmış. Harici direnç gerekiyormuş. Osiloskop ile detaylı bir analizinin yapılması gerekiyor. Tahmin edebileceğiniz üzere ILA pek yeterli bir bilgi vermiyor.

# 5. TAKIM ORGANİZASYONU

## 5.1. Takım Organizasyonu

Cengiz Emre Dedeağaç: Takımın danışmanıdır. Özyeğin Üniversitesi’nde Bilgisayar Mühendisliği bölümünde doktora yapmaktadır.

Kutay Bulun: Özyeğin Üniversitesi’nde Elektrik-Elektronik Mühendisliği bölümünde lisans öğrencisidir.

Metin Arda Köker: Özyeğin Üniversitesi’nde Bilgisayar Mühendisliği bölümünde yüksek lisans yapmaktadır.

Taha Gemici: Özyeğin Üniversitesi’nde Elektrik-Elektronik Mühendisliği bölümünde lisans öğrencisidir.

Ahmet Utku Erşahin: Özyeğin Üniversitesi’nde Elektrik-Elektronik Mühendisliği bölümünde yüksek lisans yapmaktadır.

## 5.2. Görev Dağılımı

Kutay Bulun, UART’ın UVM standardında test edilmesinden sorumludur.

Taha Gemici, sistem mimarisinden ve UART UVM dışındaki testlerden sorumludur.

Metin Arda Köker, çip tasarım akışından sorumludur.

Ahmet Utku Erşahin, çip tasarım akışından sorumludur.

# 6. İŞ PLANI ve RİSK PLANLAMASI

Açıkçası projenin büyük bir çoğunluğu bitti. Sırasıyla geriye kalan görevler:

1. USB RTL kodunun uyumlu hale getirilmesi
2. JTAG bağlantılarının yapılması
3. Geriye kalan testlerin yapılması
4. Sistemin tamamının GDSII çıktısının alınması

İlk 3 görevi Taha Gemici yapacaktır. 4. görevi Metin Arda Köker yapacaktır. 4. görev ilk 2 görev bittikten sonra yapılacaktır. Hata bulundukça düzeltilecektir.

# 7. KAYNAKÇA

[1]

[2]

[3] ChipVerify. (2024). [İnfografik]. https://www.chipverify.com/images/uvm/tb_top.svg

RAPOR TASLAKLARI İLE İLGİLİ NOT:

Bu belge Çip Tasarım Yarışması Mikrodenetleyici Kategorisi Detay Tasarım Raporu (DTR) şablonu olarak hazırlanmıştır.

Rapor, Çip Tasarım Yarışması Şartnamesi Bölüm 3.2.2’de belirtilen kurallara uygun olarak hazırlanmalıdır.

Rapor dili anlaşılırlığına, yazım düzenine, rapor içeriğine ve rapor bütünlüğüne dikkat edilmelidir.

Grafikler, resimler, devre şemaları vb. okunaklı olmalıdır. Kullanılan resimler mümkün olduğunca yüksek kaliteli olarak eklenmelidir.

Raporlar, A4 formatında, 11 punto, Calibri fontunda, satır aralığı 1.15 ve alt-üst ve yan kenarları 2.5 cm olacak şekilde hazırlanmalıdır. Detay tasarım raporu en fazla 30 sayfa olmalıdır (kapak sayfası, resimler, tablolar, referanslar dâhil).

Toplam sayfa sayısı 30’u geçmemelidir. Sayfa sınırı aşıldığı takdirde ilk 30 sayfa dikkate alınacaktır.
