TahaGemici/archozu/openlane_design/mcu/runs/RUN_2024.07.18_16.24.01/reports/metrics.csv

design | design_name | config | flow_status | total_runtime | routed_runtime | (Cell/mm^2)/Core_Util | DIEAREA_mm^2 | CellPer_mm^2 | OpenDP_Util | Final_Util | Peak_Memory_Usage_MB | synth_cell_count | tritonRoute_violations | Short_violations | MetSpc_violations | OffGrid_violations | MinHole_violations | Other_violations | Magic_violations | pin_antenna_violations | net_antenna_violations | lvs_total_errors | cvc_total_errors | klayout_violations | wire_length | vias | wns | pl_wns | optimized_wns | fastroute_wns | spef_wns | tns | pl_tns | optimized_tns | fastroute_tns | spef_tns | HPWL | routing_layer1_pct | routing_layer2_pct | routing_layer3_pct | routing_layer4_pct | routing_layer5_pct | routing_layer6_pct | wires_count | wire_bits | public_wires_count | public_wire_bits | memories_count | memory_bits | processes_count | cells_pre_abc | AND | DFF | NAND | NOR | OR | XOR | XNOR | MUX
/openlane/designs/mcu | mcu | RUN_2024.07.18_16.24.01 | flow completed | 0h1m21s0ms | 0h0m54s0ms | 67813.92712851417 | 0.0055707993 | 30516.267207831377 | 49.22 | 46.644200000000005 | 506.57 | 161 | 0 | 0 | 0 | 0 | 0 | 0 | 0 | 0 | 0 | 0 | -1 | -1 | 2265 | 977 | 0.0 | -1 | -1 | -1 | -1 | 0.0 | -1 | -1 | -1 | -1 | 1685343.0 | 0.0 | 11.51 | 14.07 | 1.14 | 3.03 | 0.0 | 344 | 2459 | 196 | 2213 | 0 | 0 | 0 | 186 | 2 | 0 | 16 | 4 | 31 | 24 | 11 | 16
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
