TahaGemici/archozu/Tests/uart_uvm/coverage/grp0.html

Dashboard Groups

Group - $unit_uart_intf_sv_2952261054::uart_cov::cov_inst

Group Info : cov_inst

Score | Num Insts | Avg Insts Score | Weight | Goal | Merge Insts | Get Inst Crvg | Per Inst | Auto Bin Max | Print Missing | Comment
100 | 1 | 100 | 1 | 100 | 0 | 0 | 0 | 64 | 0

Source File(s) : E:/vivadoProjects/uart_uvm_1.2/uart_uvm_1.2.srcs/sim_1/imports/final_uart_uvm/uart_cov.sv

Group Instance[s] Info : 1 (Total)

Name⇅ | Score⇅ | Weight | Goal | At Least | Auto Bin Max | Print Missing | Comment
obj.cov ...obj.cov_inst | 100 | 1 | 100 | 1 | 64 | 0

Instance : obj.cov_inst

Instance Info : obj.cov_inst

Score | Weight | Goal | At Least | Auto Bin Max | Print Missing | Is Instantized | Comment
100 | 1 | 100 | 1 | 64 | 0 | 1

Instance Variable[s] Summary : obj.cov_inst

Cover Points | Category | Expected | Uncovered | Covered | Avg Percent
7 | Variables | 13 | 0 | 13 | 100

Instance Cover Point[s] Details : obj.cov_inst

Name⇅ | Expected | Uncovered | Covered | Percent⇅ | Goal | Weight | At Least | Auto Bin Max | Comment
RX | 1 | 0 | 1 | 100 | 100 | 1 | 1 | 1
TX_DIN | 4 | 0 | 4 | 100 | 100 | 1 | 1 | 4
TX_START | 1 | 0 | 1 | 100 | 100 | 1 | 1 | 1
TX | 1 | 0 | 1 | 100 | 100 | 1 | 1 | 1
RX_DOUT | 4 | 0 | 4 | 100 | 100 | 1 | 1 | 4
TX_DONE | 1 | 0 | 1 | 100 | 100 | 1 | 1 | 1
RX_DONE | 1 | 0 | 1 | 100 | 100 | 1 | 1 | 1

Cover Points

Inst obj.cov_inst

RX TX_DIN TX_START TX RX_DOUT TX_DONE RX_DONE

Details of Instance Cover Point - obj.cov_inst :: RX

Summary of Cover Point - RX

Category | Expected | Uncovered | Covered | Percent
Auto Generated Bins | 1 | 0 | 1 | 100

Automatically Generated Bins for Instance Cover Point - obj.cov_inst :: RX
Covered bins

Name ⇅ | Hit Count ⇅ | At least
auto[0:1] | 5488700 | 1

Details of Instance Cover Point - obj.cov_inst :: TX_DIN

Summary of Cover Point - TX_DIN

Category | Expected | Uncovered | Covered | Percent
Auto Generated Bins | 4 | 0 | 4 | 100

Automatically Generated Bins for Instance Cover Point - obj.cov_inst :: TX_DIN
Covered bins

Name ⇅ | Hit Count ⇅ | At least
auto[0:63] | 1591725 | 1
auto[64:127] | 1152627 | 1
auto[128:191] | 1317286 | 1
auto[192:255] | 1427062 | 1

Details of Instance Cover Point - obj.cov_inst :: TX_START

Summary of Cover Point - TX_START

Category | Expected | Uncovered | Covered | Percent
Auto Generated Bins | 1 | 0 | 1 | 100

Automatically Generated Bins for Instance Cover Point - obj.cov_inst :: TX_START
Covered bins

Name ⇅ | Hit Count ⇅ | At least
auto[0:1] | 5488700 | 1

Details of Instance Cover Point - obj.cov_inst :: TX

Summary of Cover Point - TX

Category | Expected | Uncovered | Covered | Percent
Auto Generated Bins | 1 | 0 | 1 | 100

Automatically Generated Bins for Instance Cover Point - obj.cov_inst :: TX
Covered bins

Name ⇅ | Hit Count ⇅ | At least
auto[0:1] | 5488700 | 1

Details of Instance Cover Point - obj.cov_inst :: RX_DOUT

Summary of Cover Point - RX_DOUT

Category | Expected | Uncovered | Covered | Percent
Auto Generated Bins | 4 | 0 | 4 | 100

Automatically Generated Bins for Instance Cover Point - obj.cov_inst :: RX_DOUT
Covered bins

Name ⇅ | Hit Count ⇅ | At least
auto[0:63] | 1587728 | 1
auto[64:127] | 1266396 | 1
auto[128:191] | 1317288 | 1
auto[192:255] | 1317288 | 1

Details of Instance Cover Point - obj.cov_inst :: TX_DONE

Summary of Cover Point - TX_DONE

Category | Expected | Uncovered | Covered | Percent
Auto Generated Bins | 1 | 0 | 1 | 100

Automatically Generated Bins for Instance Cover Point - obj.cov_inst :: TX_DONE
Covered bins

Name ⇅ | Hit Count ⇅ | At least
auto[0:1] | 5488700 | 1

Details of Instance Cover Point - obj.cov_inst :: RX_DONE

Summary of Cover Point - RX_DONE

Category | Expected | Uncovered | Covered | Percent
Auto Generated Bins | 1 | 0 | 1 | 100

Automatically Generated Bins for Instance Cover Point - obj.cov_inst :: RX_DONE
Covered bins

Name ⇅ | Hit Count ⇅ | At least
auto[0:1] | 5488700 | 1
