TahaGemici/archozu/Tests/core_verification/riscv-dv/out_2024-08-27/spike_sim/riscv_arithmetic_basic_test_0.csv

pc | instr | gpr | csr | binary | mode | instr_str | operand | pad
80000000 | csrrw | t0:00000000 |  | f14022f3 | 3 | csrr t0, mhartid | t0,mhartid,zero
80000004 | c.li | t1:00000000 |  | 00004301 | 3 | c.li t1, 0 | t1,0
80000006 | beq |  |  | 00628263 |  | beq t0, t1, 4 | t0,t1,4
8000000a | auipc | s5:8000000a |  | 00000a97 | 3 | auipc s5, 0x0 | s5,0x0
8000000e | addi | s5:80000016 |  | 00ca8a93 | 3 | addi s5, s5, 12 | s5,s5,12
80000012 | jalr |  |  | 000a8067 |  | jr s5 | zero,s5,0
80000016 | lui | t4:40001000 |  | 40001eb7 | 3 | lui t4, 0x40001 | t4,0x40001
8000001a | addi | t4:40001104 |  | 104e8e93 | 3 | addi t4, t4, 260 | t4,t4,260
8000001e | csrrw |  |  | 301e9073 |  | csrw misa, t4 | zero,misa,t4
80000022 | auipc | t6:80013022 |  | 00013f97 | 3 | auipc t6, 0x13 | t6,0x13
80000026 | addi | t6:80012c84 |  | c62f8f93 | 3 | addi t6, t6, -926 | t6,t6,-926
8000002a | auipc | t4:8000802a |  | 00008e97 | 3 | auipc t4, 0x8 | t4,0x8
8000002e | addi | t4:800084d4 |  | 4aae8e93 | 3 | addi t4, t4, 1194 | t4,t4,1194
80000032 | ori | t4:800084d4 |  | 000eee93 | 3 | ori t4, t4, 0 | t4,t4,0
80000036 | csrrw |  |  | 305e9073 |  | csrw mtvec, t4 | zero,mtvec,t4
8000003a | auipc | t4:8000003a |  | 00000e97 | 3 | auipc t4, 0x0 | t4,0x0
8000003e | addi | t4:8000005a |  | 020e8e93 | 3 | addi t4, t4, 32 | t4,t4,32
80000042 | csrrw |  |  | 341e9073 |  | csrw mepc, t4 | zero,mepc,t4
80000046 | c.lui | t4:00002000 |  | 00006e89 | 3 | c.lui t4, 0x2 | t4,0x2
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
8000138a | sra | t1:00000000 |  | 419a5333 | 3 | sra t1, s4, s9 | t1,s4,s9
8000138e | c.or | a3:80000230 |  | 00008ed5 | 3 | c.or a3, a3 | a3,a3
80001390 | srl | s8:8815dea0 |  | 01045c33 | 3 | srl s8, s0, a6 | s8,s0,a6
80001394 | mul | a6:00000000 |  | 03240833 | 3 | mul a6, s0, s2 | a6,s0,s2
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
