TahaGemici/archozu/RTL/ila.xdc

connect_debug_port u_ila_0/probe1 [get_nets [list {bus/I2C_master_v2/counter[0]} {bus/I2C_master_v2/counter[1]} {bus/I2C_master_v2/counter[2]}]]
connect_debug_port u_ila_0/probe2 [get_nets [list {bus/I2C_master_v2/nby_counter[0]} {bus/I2C_master_v2/nby_counter[1]} {bus/I2C_master_v2/nby_counter[2]}]]



create_debug_core u_ila_0 ila
set_property ALL_PROBE_SAME_MU true [get_debug_cores u_ila_0]
set_property ALL_PROBE_SAME_MU_CNT 4 [get_debug_cores u_ila_0]
set_property C_ADV_TRIGGER true [get_debug_cores u_ila_0]
set_property C_DATA_DEPTH 32768 [get_debug_cores u_ila_0]
set_property C_EN_STRG_QUAL true [get_debug_cores u_ila_0]
set_property C_INPUT_PIPE_STAGES 0 [get_debug_cores u_ila_0]
set_property C_TRIGIN_EN false [get_debug_cores u_ila_0]
set_property C_TRIGOUT_EN false [get_debug_cores u_ila_0]
set_property port_width 1 [get_debug_ports u_ila_0/clk]
connect_debug_port u_ila_0/clk [get_nets [list clk_gen/clk]]
set_property PROBE_TYPE DATA_AND_TRIGGER [get_debug_ports u_ila_0/probe0]
set_property port_width 3 [get_debug_ports u_ila_0/probe0]
connect_debug_port u_ila_0/probe0 [get_nets [list {bus/USB/state[0]} {bus/USB/state[1]} {bus/USB/state[2]}]]
set_property C_CLK_INPUT_FREQ_HZ 300000000 [get_debug_cores dbg_hub]
set_property C_ENABLE_CLK_DIVIDER false [get_debug_cores dbg_hub]
set_property C_USER_SCAN_CHAIN 1 [get_debug_cores dbg_hub]
connect_debug_port dbg_hub/clk [get_nets clk]
