TahaGemici/archozu/openlane_design/mcu/runs/RUN_2024.07.18_16.24.01/results/final/verilog/gl/mcu.v

module mcu (VGND,
    VPWR,
    clk,
    cs,
    rst,
    rx,
    scl_io,
    sclk,
    sda_io,
    tx,
    in,
    io,
    out);
 input VGND;
 input VPWR;
 input clk;
 output cs;
 input rst;
 input rx;
 output scl_io;
 output sclk;
 inout sda_io;
 output tx;
 input [15:0] in;
 inout [3:0] io;
 output [15:0] out;

 wire net9;
 wire net19;
 wire net20;
 wire net21;
 wire net22;
 wire net23;
 wire net24;
 wire net10;
 wire net11;
 wire net12;
 wire net13;
 wire net14;
 wire net15;
 wire net16;
 wire net17;
 wire net18;
 wire net25;
 wire _000_;
 wire _001_;
 wire _002_;
 wire _003_;
 wire _004_;
 wire _005_;
 wire _006_;
 wire _007_;
 wire _008_;
 wire _009_;
 wire _010_;
 wire _011_;
 wire _012_;
 wire _013_;
 wire _014_;
 wire _015_;
 wire _016_;
 wire _017_;
 wire _018_;
 wire _019_;
 wire _020_;
 wire _021_;
 wire _022_;
 wire _023_;
 wire _024_;
 wire _025_;
 wire _026_;
 wire _027_;
 wire _028_;
 wire _029_;
 wire _030_;
 wire _031_;
 wire _032_;
 wire _033_;
 wire _034_;
 wire _035_;
 wire _036_;
 wire _037_;
 wire _038_;
 wire _039_;
 wire _040_;
 wire _041_;
 wire _042_;
 wire _043_;
 wire _044_;
 wire _045_;
 wire _046_;
 wire _047_;
 wire _048_;
 wire _049_;
 wire _050_;
 wire _051_;
 wire _052_;
 wire _053_;
 wire _054_;
 wire _055_;
 wire _056_;
 wire _057_;
 wire _058_;
 wire _059_;
 wire _060_;
 wire _061_;
 wire _062_;
 wire _063_;
 wire _064_;
 wire _065_;
 wire _066_;
 wire _067_;
 wire _068_;
 wire _069_;
 wire _070_;
 wire _071_;
 wire _072_;
 wire _073_;
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
 assign out[15] = net24;
 assign out[1] = net10;
 assign out[2] = net11;
 assign out[3] = net12;
 assign out[4] = net13;
 assign out[5] = net14;
 assign out[6] = net15;
 assign out[7] = net16;
 assign out[8] = net17;
 assign out[9] = net18;
 assign scl_io = net25;
endmodule
