TahaGemici/archozu/RTL/mcu_tb.v

module mcu_tb();
    reg sys_clk, sys_rst;
    initial begin
        sys_clk = 0;
        forever begin
            sys_clk = #(`CLK_PERIOD/2.0) ~sys_clk;
        end
    end
    initial begin
        sys_rst = 1;
        #500000; //flash_mem için bu kadar uzun
        sys_rst = 0;
        #100000000;
        $finish;
    end
    
    reg[15:0] in;
    initial begin
        forever in = #500 $random;
    end

    tri1 sda_io, scl_io;
    wire rx, tx, sclk, cs;
    wire[3:0] io;
    wire[15:0] out;

    wire tx_done;
    reg tx_en;
    wire[7:0] rx_data;
    reg[7:0] tx_data;

    initial begin
        tx_en = 0;
        wait(sys_rst==0);
        #5000000;
        forever begin
            tx_data = rx_data;
            tx_en = 1;
            #100;
            tx_en = 0;
            #300000;
        end
    end

    uart_test #(5207) uart_test( //BAUDRATE=9600
        sys_clk,

        tx,
        rx_data,

        rx,
        tx_en,
        tx_data,
        tx_done
    );

    i2c_slave_controller #(121) I2C_slave0(
        scl_io,
        sda_io,
        sys_rst
    );
    i2c_slave_controller #(74) I2C_slave1(
        scl_io,
        sda_io,
        sys_rst
    );
    i2c_slave_controller #(12) I2C_slave2(
        scl_io,
        sda_io,
        sys_rst
    );
    i2c_slave_controller #(31) I2C_slave3(
        scl_io,
        sda_io,
        sys_rst
    );

`ifndef NO_FLASH
    s25fl128s flash_mem(
        io[0],
        io[1],
        sclk,
        cs,
        ~sys_rst,
        io[2],
        io[3]
    );

`endif

    wire usb_dp_pull, usb_dp, usb_dn;
    mcu mcu(
        sys_rst,
        sys_clk,
        rx,
        tx,
        sda_io,
        scl_io,
        sclk,
        cs,
        io,
        in,
        out,
        usb_dp_pull,
        usb_dp,
        usb_dn
    );
endmodule
