TahaGemici/archozu/(commit log)

2024-03-27 partially complete uvm for uart
2024-04-06 timer finito ama hiç sentezlemedüm syntax hatası olabilir
2024-04-13 timer düzeltilecek
2024-04-23 timer completed
2024-04-24 interrupt added
2024-04-25 scoreboard is to do, update driver and monitor
2024-06-05 qspi addr needs to be fixed
    [QSPI_master.v, instr_mem.v, rom.v]
2024-06-11 KnightRider test cases for gpio, uart, ic2 created
2024-06-11 test1 test cases for gpio, uart, ic2 created
2024-06-11 dosyaları derledim
    [s25fl128s_verilog.sdf, s25fl128s_vhdl.sdf]
2024-06-12 clk gen and clk gen testbench added for uart uvm
2024-06-13 sample uart to test added
2024-06-14 added sequence item and sequences for uart uvm
2024-06-16 uart_driver and uart_monitor added for uart_uvm_tb
2024-06-25 Refactor I2C_master module to improve clock handling
2024-06-30 fixed timer
2024-07-02 fixed multidriven net error
    [QSPI_master.v]
2024-07-14 fixed uart
2024-07-20 Openlane tasarım dosyaları ve sonuçları eklendi
    [24-wire_lengths.csv, mcu.Fastest.sdf, mcu.Slowest.sdf, mcu.Typical.sdf, mcu.sdf, metrics.csv, pin_order.cfg]
2024-07-25 updated uart_uvm
2024-08-27 i2c fix
2024-08-27 core verif
    [riscv_arithmetic_basic_test_0.csv, riscv_arithmetic_basic_test_1.csv]
2024-08-27 uart driver updated
2024-08-28 uart_core and uart_top added
